CwbhX/GrokKiCADWatch/SmartWatch V5.kicad_pcb

## KiCad design SmartWatch V5.kicad_pcb (2025-12-07)

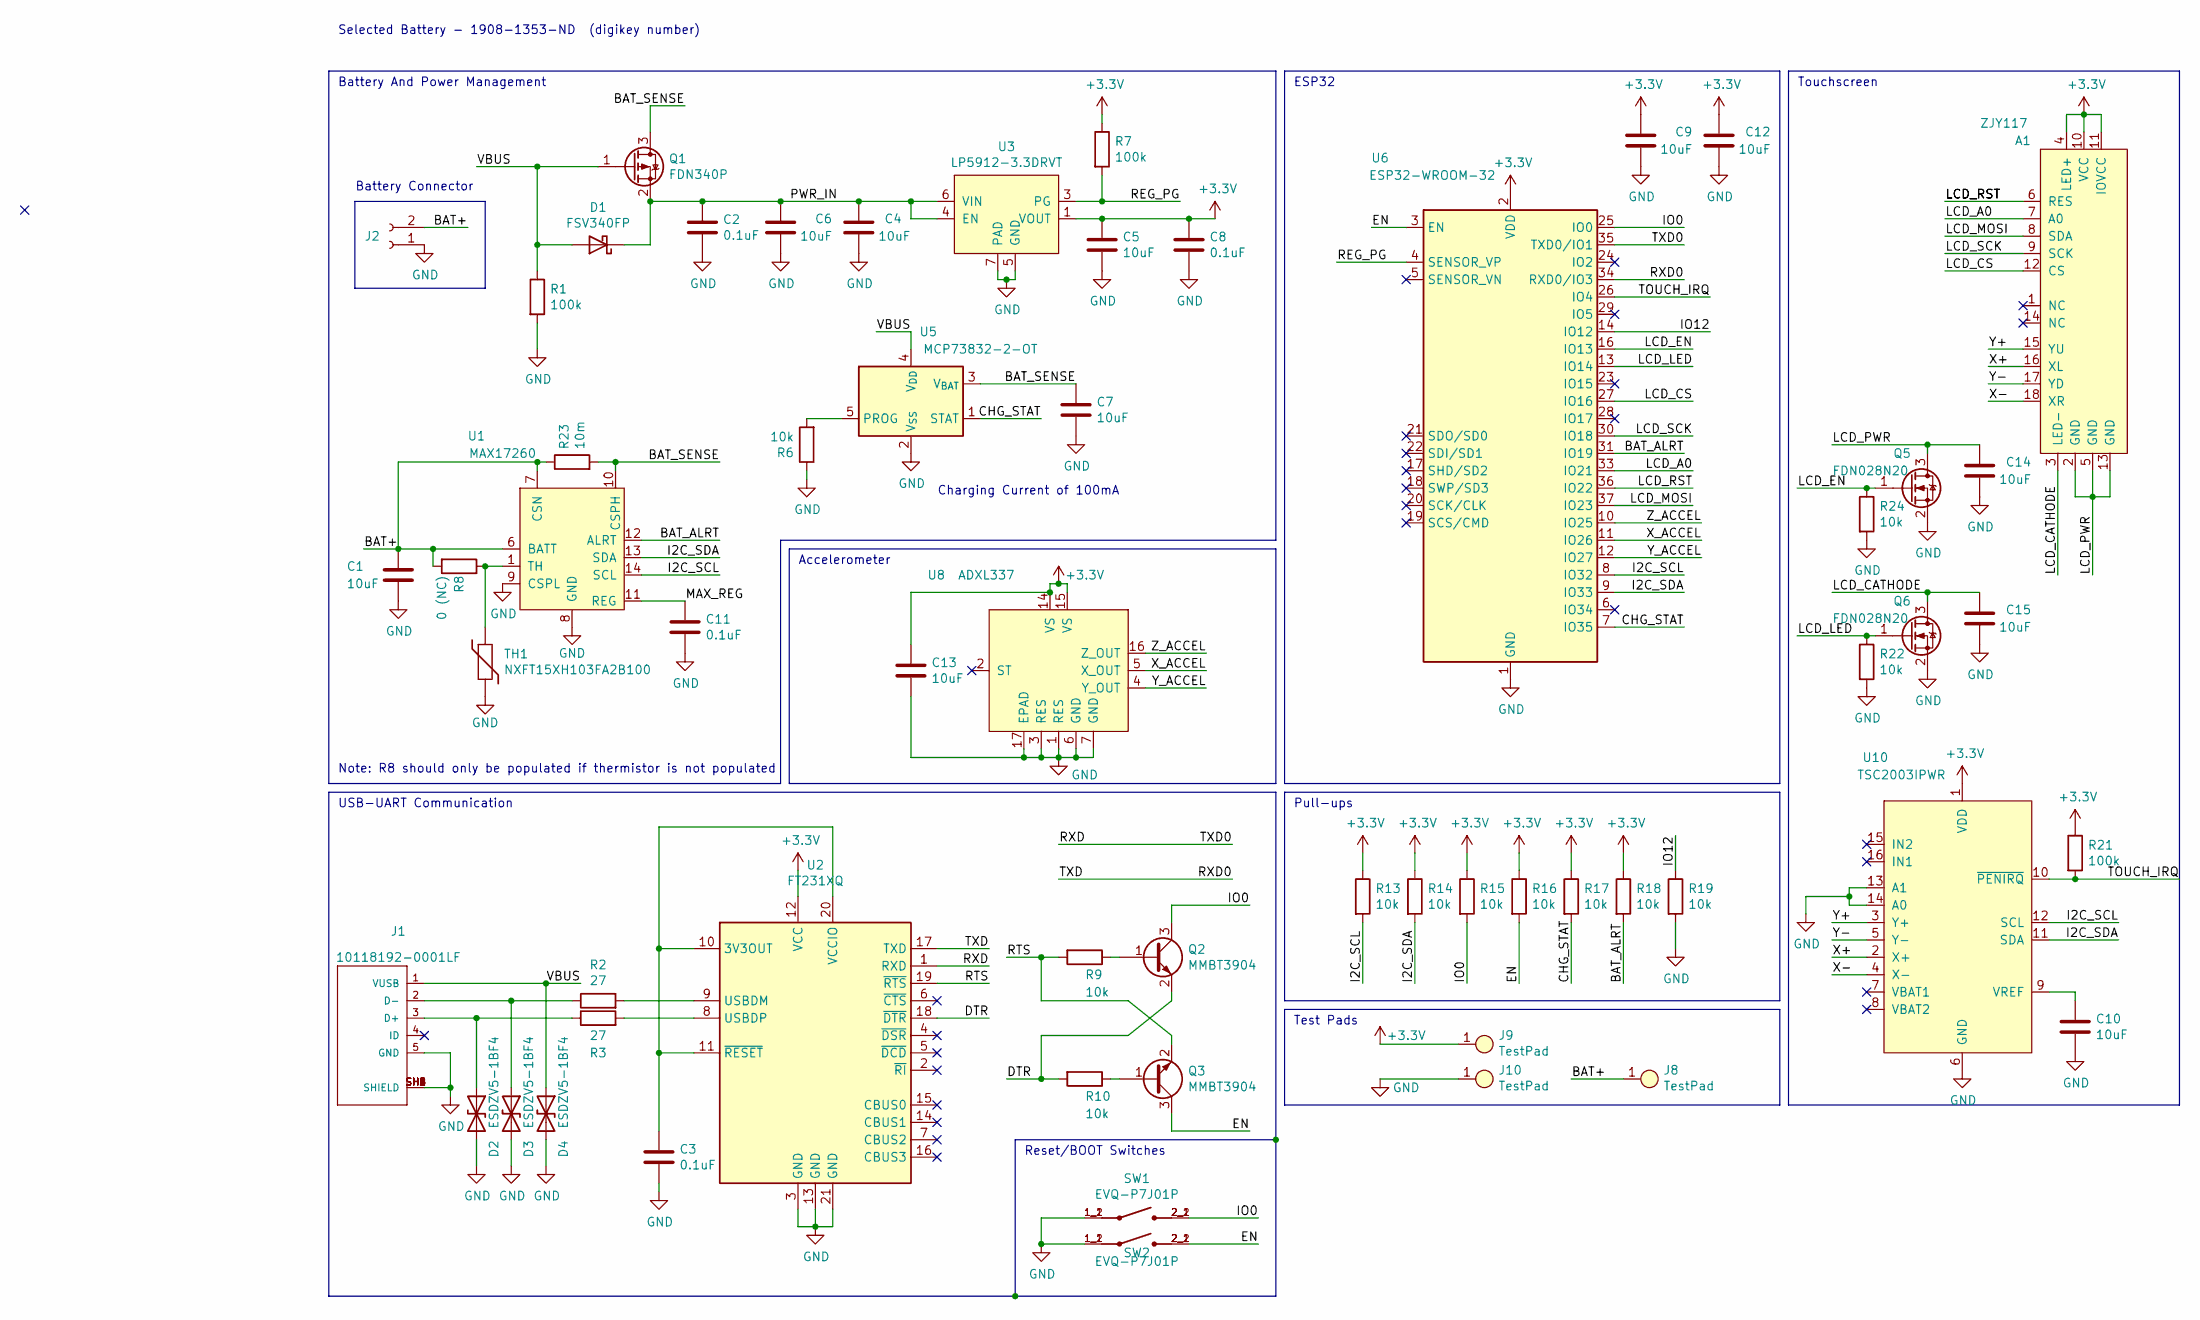
[picture p1: schematic SmartWatch V5.kicad_sch, ESP32 Custom SmartWatch]

Parts:
A1: ZJY117
C1, C4, C5, C6, C7, C9, C10, C12, C13, C14, C15: 10uF; C_0603_1608Metric; digikey 478-10766-1-ND
C2, C3, C8, C11: 0.1uF; C_0603_1608Metric; digikey 1276-1006-1-ND
D1: FSV340FP; D_SOD-123; digikey FSV340FPCT-ND
D2, D3, D4: ESDZV5-1BF4; D_0201_0603Metric; digikey 497-17318-1-ND
J1: 10118192-0001LF; AMPHENOL_10118192-0001LF; digikey 609-4613-1-ND
J2: BATTERY
J8, J9, J10: TestPad; TESTPAD
Q1: FDN340P; SOT-23; digikey FDN340PCT-ND
Q2, Q3: MMBT3904; SOT-23; digikey 1727-4044-1-ND
Q5, Q6: FDN028N20; SOT-23; digikey FDN028N20OSCT-ND
R1, R7, R21: 100k; R_0603_1608Metric; digikey CR0603-JW-104ELFCT-ND
R2, R3: 27; R_0603_1608Metric; digikey RMCF0603JT27R0CT-ND
R6, R9, R10, R13, R14, R15, R16, R17, R18, R19, R22, R24: 10k; R_0603_1608Metric; digikey 311-10.0KCRCT-ND
R8: 0 (NC); R_0603_1608Metric; digikey 311-0.0GRCT-ND
R23: 10m; R_0805_2012Metric; digikey RL12T.010JCT-ND
SW1, SW2: EVQ-P7J01P; SW_EVQ-P7J01P; digikey P16767CT-ND
TH1: NXFT15XH103FA2B100; PinHeader_1x02_P1.00mm_Vertical; digikey 490-5630-ND
U1: MAX17260; TDFN16-EP; digikey 175-MAX17260SEWL+TCT-ND
U2: FT231XQ; QFN-20-1EP_4x4mm_P0.5mm_EP2.5x2.5mm; digikey 768-1128-1-ND
U3: LP5912-3.3DRVT; WSON-6-1EP_2x2mm_P0.65mm_EP1x1.6mm_ThermalVias; digikey 296-44153-1-ND
U5: MCP73832-2-OT; SOT-23-5; digikey MCP73832T-2ACI/OTCT-ND
U6: ESP32-WROOM-32; digikey 1904-1010-1-ND
U8: ADXL337; ADXL337BCPZ-RL; digikey ADXL337BCPZ-RLCT-ND
U10: TSC2003IPWR; TSSOP-16_4.4x5mm_P0.65mm; digikey 296-14340-1-ND

Connections:
+3V3: A1.4 (LED+), A1.10 (VCC), A1.11 (IOVCC), C5.1, C8.1, C9.1, C12.1, C13.1, J9.1, R7.1, R13.1, R14.1, R15.1, R16.1, R17.1, R18.1, R21.1, U2.12 (VCC), U3.1 (VOUT), U6.2 (VDD), U8.14 (VS), U8.15 (VS), U10.1 (VDD)
/BAT+: C1.1, J2.2, J8.1, R8.2, R23.1, U1.6 (BATT), U1.7 (CSN)
/BAT_ALRT: R18.2, U1.12 (ALRT), U6.31 (IO19)
/BAT_SENSE: C7.1, Q1.3 (D), R23.2, U1.10 (CSPH), U5.3 (V_{BAT})
/CHG_STAT: R17.2, U5.1 (STAT), U6.7 (IO35)
/DTR: Q2.2 (E), R10.2, U2.18 (~DTR)
/EN: Q3.3 (C), R16.2, SW2.2_1 (2), SW2.2_2 (2), U6.3 (EN)
/I2C_SCL: R13.2, U1.14 (SCL), U6.8 (IO32), U10.12 (SCL)
/I2C_SDA: R14.2, U1.13 (SDA), U6.9 (IO33), U10.11 (SDA)
/IO0: Q2.3 (C), R15.2, SW1.2_1 (2), SW1.2_2 (2), U6.25 (IO0)
/IO12: R19.1, U6.14 (IO12)
/LCD_A0: A1.7 (A0), U6.33 (IO21)
/LCD_CATHODE: A1.3 (LED-), C15.1, Q6.3 (D)
/LCD_CS: A1.12 (CS), U6.27 (IO16)
/LCD_EN: Q5.1 (G), R24.1, U6.16 (IO13)
/LCD_LED: Q6.1 (G), R22.1, U6.13 (IO14)
/LCD_MOSI: A1.8 (SDA), U6.37 (IO23)
/LCD_PWR: A1.2 (GND), A1.5 (GND), A1.13 (GND), C14.1, Q5.3 (D)
/LCD_RST: A1.6 (RES), U6.36 (IO22)
/LCD_SCK: A1.9 (SCK), U6.30 (IO18)
/MAX_REG: C11.1, U1.11 (REG)
/PWR_IN: C2.1, C4.1, C6.1, D1.1 (K), Q1.2 (S), U3.4 (EN), U3.6 (VIN)
/REG_PG: R7.2, U3.3 (PG~), U6.4 (SENSOR_VP)
/RTS: Q3.2 (E), R9.2, U2.19 (~RTS)
/RXD: U2.1 (RXD), U6.35 (TXD0/IO1)
/RXD0: U2.17 (TXD), U6.34 (RXD0/IO3)
/TOUCH_IRQ: R21.2, U6.26 (IO4), U10.10 (~PENIRQ)
/VBUS: D1.2 (A), D4.1 (A1), J1.1 (VUSB), Q1.1 (G), R1.1, U5.4 (V_{DD})
/X+: A1.16 (XL), U10.2 (X+)
/X-: A1.18 (XR), U10.4 (X-)
/X_ACCEL: U6.11 (IO26), U8.5 (X_OUT)
/Y+: A1.15 (YU), U10.3 (Y+)
/Y-: A1.17 (YD), U10.5 (Y-)
/Y_ACCEL: U6.12 (IO27), U8.4 (Y_OUT)
/Z_ACCEL: U6.10 (IO25), U8.16 (Z_OUT)
unnamed: C3.1, U2.10 (3V3OUT), U2.11 (~RESET), U2.20 (VCCIO)
unnamed: C10.1, U10.9 (VREF)
unnamed: D2.1 (A1), J1.3 (D+), R3.1
unnamed: D3.1 (A1), J1.2 (D-), R2.1
unnamed: Q2.1 (B), R9.1
unnamed: Q3.1 (B), R10.1
unnamed: R2.2, U2.9 (USBDM)
unnamed: R3.2, U2.8 (USBDP)
unnamed: R6.2, U5.5 (PROG)
unnamed: R8.1, TH1.1, U1.1 (TH)

Notes on the sheet:
Accelerometer
USB-UART Communication
Charging Current of 100mA
Selected Battery - 1908-1353-ND (digikey number)
Test Pads
Pull-ups
Note: R8 should only be populated if thermistor is not populated
Battery Connector
Reset/BOOT Switches
Touchscreen
ESP32
Battery And Power Management

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
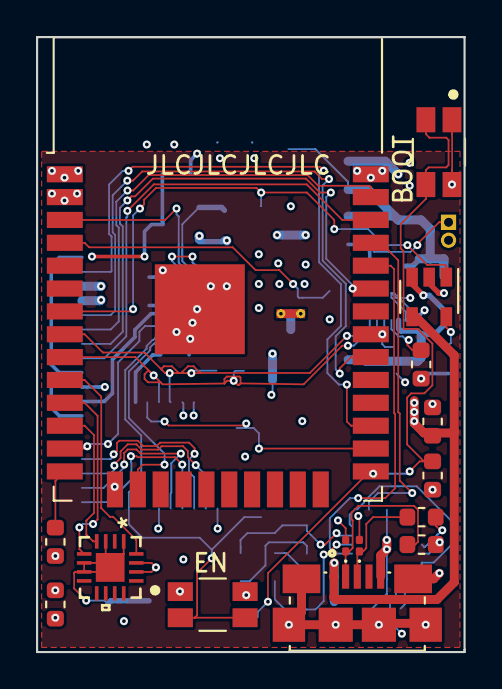
[picture p2: board SmartWatch V5.kicad_pcb from above]

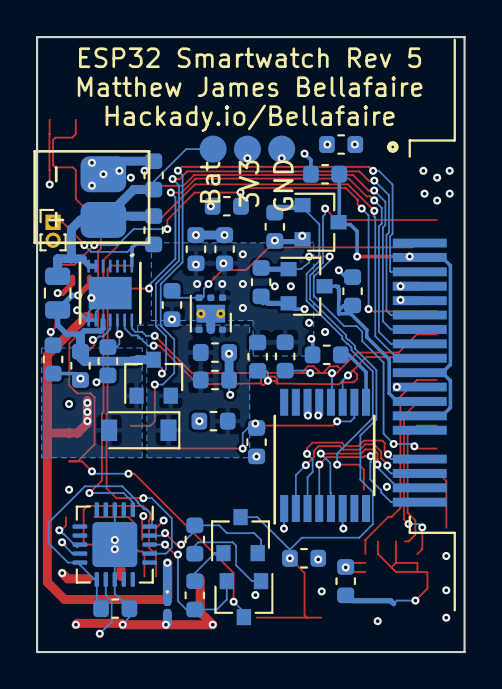
[picture p3: board SmartWatch V5.kicad_pcb from below]

Board: 4 copper layers, 23.7 x 34.2 mm, 59 parts (44 on the bottom side), 46 nets.
