CwbhX/GrokKiCADWatch/(commit log)

2025-12-07 Initial commit of my amazing smart watch using the esp32
    [SmartWatch V5.kicad_pcb, SmartWatch V5.kicad_sch]
2025-12-07 Updated part parameters
    [SmartWatch V5.kicad_sch]
2025-12-07 Updated accel to newer model
    [SmartWatch V5.kicad_sch]
2025-12-07 revert kicad_sch for testing
    [SmartWatch V5.kicad_sch]
